korn0055/bean-bag-toss/spice_models/readme.txt

Adam Bush

The only difference between the MAX9031 and the MAX9021 actually used in circuit is prop delay and current draw.  Supply voltages, and input ranges are the same.  It should be ok for simulation purposes.
