korn0055/bean-bag-toss/drawings/laser_cutout.pdf

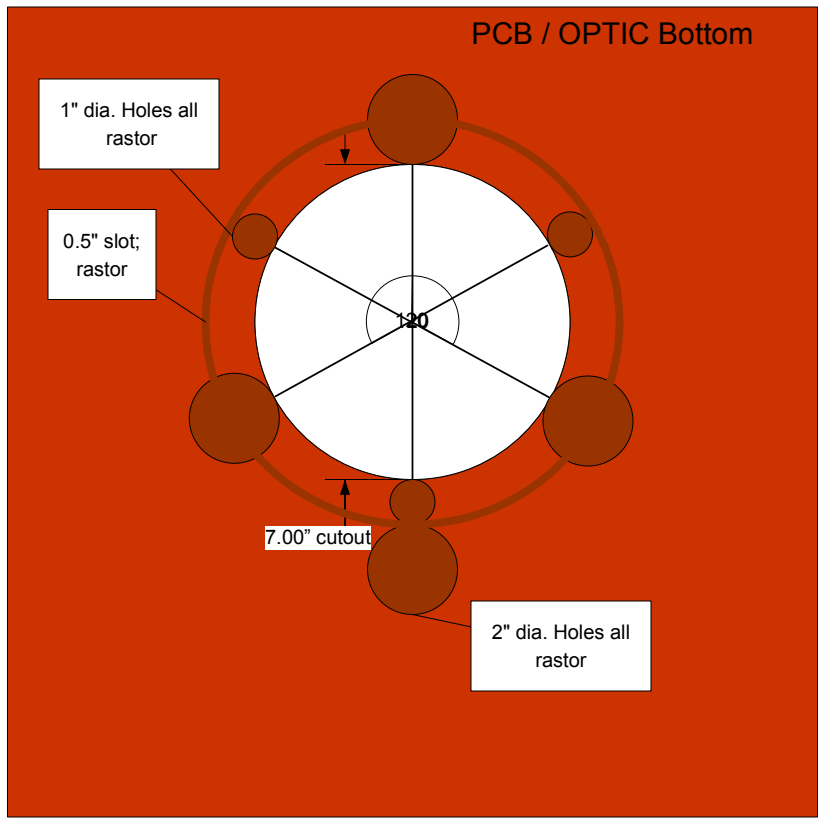
[picture p1: figure]
7.00” cutout; PCB / OPTIC Bottom; 1" dia. Holes all; rastor; 0.5" slot;; 2" dia. Holes all
