korn0055/bean-bag-toss/drawings/frame/frame.png

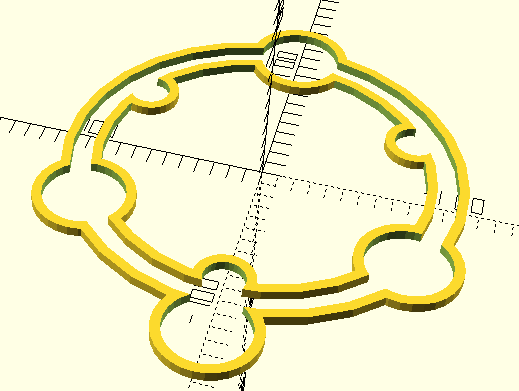
drawings/frame/frame.png
