korn0055/bean-bag-toss/pcb/BOM_grouped.xlsx

# | RefDes | Value | Name | Quantity | Total/Panel | Stock | Note | Digikey Number | Qty | Unit cost | Cost | Mouser | Qty | Unit cost | Cost | Dirty PCB | Order Number
1 | C1 | 3.3pF | CAP_0402 | 1 | 1 | Y | Sub 3.5pF | 1276-1692-1-ND | 100 | 0.0051 | $0.51 |  |  |  |  | PCBs | File | Layers | Size (actual) | Color | Thickness | Coating | Stencil | Processing | Quantity | Charge | Status
2 | C2 | 4.7uF | CAP_0603 | 1 | 1 | N |  | 587-1441-1-ND | 10 | 0.157 | $1.57 |  |  |  |  | 5207 | Optical_txrx.zip | 2 | 10x10cm (10x10cm) | Blue | 1.6mm | ENIG | Steel | Rush | Protopack ±10 | $90 | Shipped
3 | C3 | 15uF | CAP_0805 | 1 | 1 | N | sub 10uF | 1276-2891-1-ND | 10 | 0.205 | $2.05 |  |  |  |  | Total
4 | C4 | 47nF | CAP_0402 | 1 | 1 | N |  | 1276-1750-1-ND | 10 | 0.011 | $0.11 |  |  |  |  | Shipping | DHL China (3-9 days) |  |  |  |  |  |  |  |  | $15 | 0.42kg
5 | C5, C6 | 1uF | CAP_0402 | 2 | 2 | Y |  | 709-1222-1-ND | 25 | 0.0996 | $2.49 |  |  |  |  | Total |  |  |  |  |  |  |  |  |  | $105
6 | C7 | 1n | CAP_0402 | 1 | 1 | Y |  | 709-1133-1-ND | 25 | 0.022 | $0.55
7 | C8 | PH_RES | CAP | 1 | 1 | N |  | PDV-P8103-ND | 2 | 0.89 | $1.78
8 | C101, C103 | 0.1uF | CAP_0402 | 2 | 6 | Y |  | 709-1129-1-ND | 25 | 0.0452 | $1.13 |  |  |  |  | PROJECT TOTAL TO DATE:
9 | C102 | 10nF | CAP_0402 | 1 | 3 | Y |  | 709-1127-1-ND | 50 | 0.0208 | $1.04 |  |  |  |  |  | Digikey = | $79.30
10 | C104 | 500pF | CAP_0402 | 1 | 3 | Y | sub 1n or 220pF |  |  |  |  |  |  |  |  |  | Mouser = | $12.13
11 | D1 |  | DIODE_0603 | 1 | 1 | N | Actually SOD-123 | SD101AWTPMSCT-ND | 10 | 0.322 | $3.22 |  |  |  |  |  | DirtyPCB = | $105
12 | D101, D102 |  | DIODE_0402 | 2 | 6 | N | shouldn't need | 641-1287-1-ND | 6 | 0.52 | $3.12
13 | D103 |  | PD | 1 | 3 | Y
14 | J1, J4 |  | 644456-2 | 2 | 2 | DNP |  |  |  |  |  |  |  |  |  |  | TOTAL = | $196.43
15 | J2 |  | 87758-06 | 1 | 1 | N |  | 952-2121-ND | 10 | 0.214 | $2.14
16 | J3, J5, J6, J101, J102 |  | 951106-4620 | 5 | 9 | DNP
17 | L1 | 4.7uH | SRN5020-4R7M | 1 | 1 | N |  | SRN5020-4R7MCT-ND | 10 | 0.32 | $3.20
18 | Q1, Q2, Q3 |  | BS870 | 3 | 3 | N |  | BS870-FDICT-ND | 6 | 0.35 | $2.10
19 | Q5 |  | AO3416 | 1 | 1 | N |  | 785-1011-1-ND | 2 | 0.4 | $0.80
20 | Q101, Q102 |  | 2SK1828 | 2 | 6 | N |  | 2SK1828TE85LFCT-ND | 12 | 0.324 | $3.89
21 | R1 | 1MEG | RES_0402 | 1 | 1 | Y | Can't sub value | RHM1.00MCDCT-ND | 100 | 0.0052 | $0.52
22 | R2 | 115k | RES_0402 | 1 | 1 | N | Can't sub value | P115KLCT-ND | 100 | 0.0149 | $1.49
23 | R3, R4, R5 | 200 | RES_0402 | 3 | 3 | Y |  | 311-200LRCT-ND | 100 | 0.006 | $0.60
24 | R6 | 10k | RES_0402 | 1 | 1 | Y |  | RHM10.0KCDCT-ND | 100 | 0.0052 | $0.52
25 | R7, R104 | 100k | RES_0402 | 2 | 4 | Y |  | RHM100KCDCT-ND | 100 | 0.0052 | $0.52
26 | R101, RX1, RX2, RX3 | 50 | RES_0402 | 4 | 4 | Y | sub 51 ohm | RHM51.0CDCT-ND | 100 | 0.0052 | $0.52
27 | R102 | 2MEG | RES_0402 | 1 | 3 | Y |  | RHM2MCDCT-ND | 100 | 0.0074 | $0.74
28 | R103, R106, R108 | 332k | RES_0402 | 3 | 9 | Y | sub 330 | 311-330KLRCT-ND | 100 | 0.006 | $0.60
29 | R109 | 1X | RES_0402 | 1 | 3 | Y |  | ***See above
30 | U1 |  | LT3467ES6 | 1 | 1 | N |  | LT3467ES6#TRMPBFCT-ND | 3 | 4.16 | $12.48
31 | U2 |  | MCP1801_OT | 1 | 1 | N |  | MCP1801T-5002I/OTCT-ND | 4 | 0.5 | $2.00
32 | U3 |  | ATTINY24_QFN | 1 | 1 | N |  | ATTINY24-20MU-ND | 2 | 2.93 | $5.86
33 | U101 |  | MAX9021AUK-T | 1 | 3 | N |  | ***Non stock |  |  |  | 700-MAX9021AUKT | 6 | 0.69 | 4.14
34 | U102 |  | AD8061ARTZ | 1 | 3 | N |  | AD8061ARTZ-REEL7CT-ND | 6 | 2.27 | $13.62
 |  |  |  | 53 |  |  |  |  |  | Subtotal | $69.17 |  |  | Subtotal | $4.14
 |  |  |  |  |  |  |  |  |  | Shipping (est) | 5.1 |  |  | Shipping (est) | 7.99
 |  |  |  |  |  |  |  |  |  | Tax | 5.03 |  |  | Total = | $12.13
 |  |  |  |  |  |  |  |  |  | Total = | $79.30
