korn0055/bean-bag-toss/drawings/frame/frame.stl

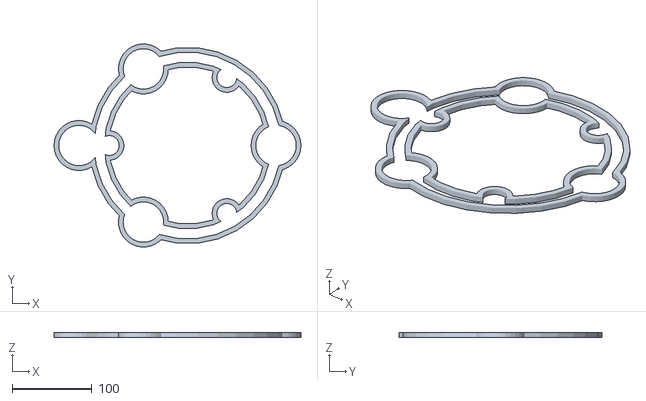
[picture p3: CAD file, 2015-06-09]
drawings/frame/frame.stl
310.5 x 254.9 x 6.00
