korn0055/bean-bag-toss/(list of files, cad)

Other CAD files:
drawings/frame/frame.dxf
