korn0055/bean-bag-toss/(list of files, drawings)

Other design files:
pcb/beanbagtoss.dch
pcb/beanbagtoss.dip
