korn0055/bean-bag-toss/drawings/FaceDown-3x2-board-instructions.pdf

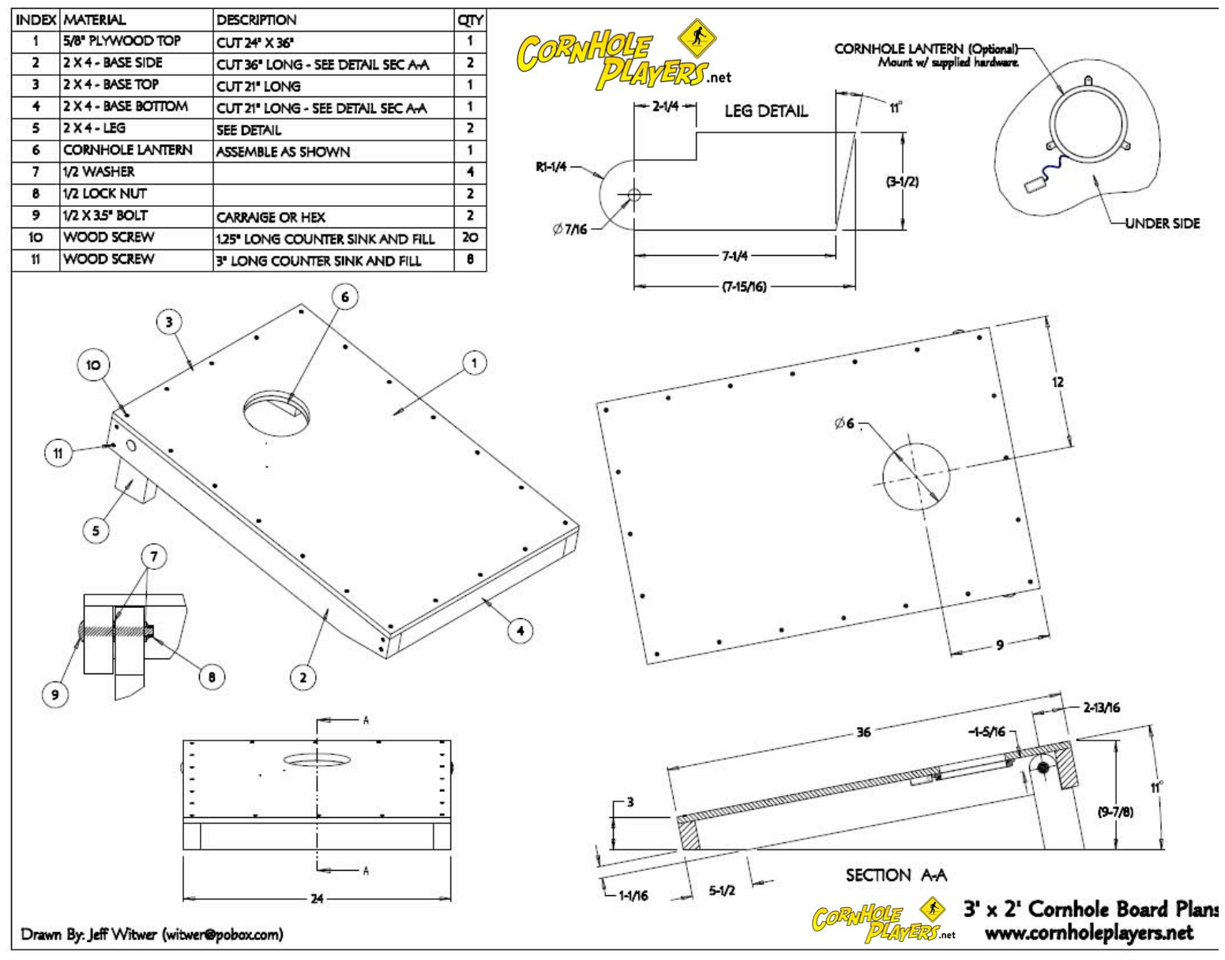
[picture p4: page 1]
