korn0055/bean-bag-toss/pcb/assembly_aid.jpg

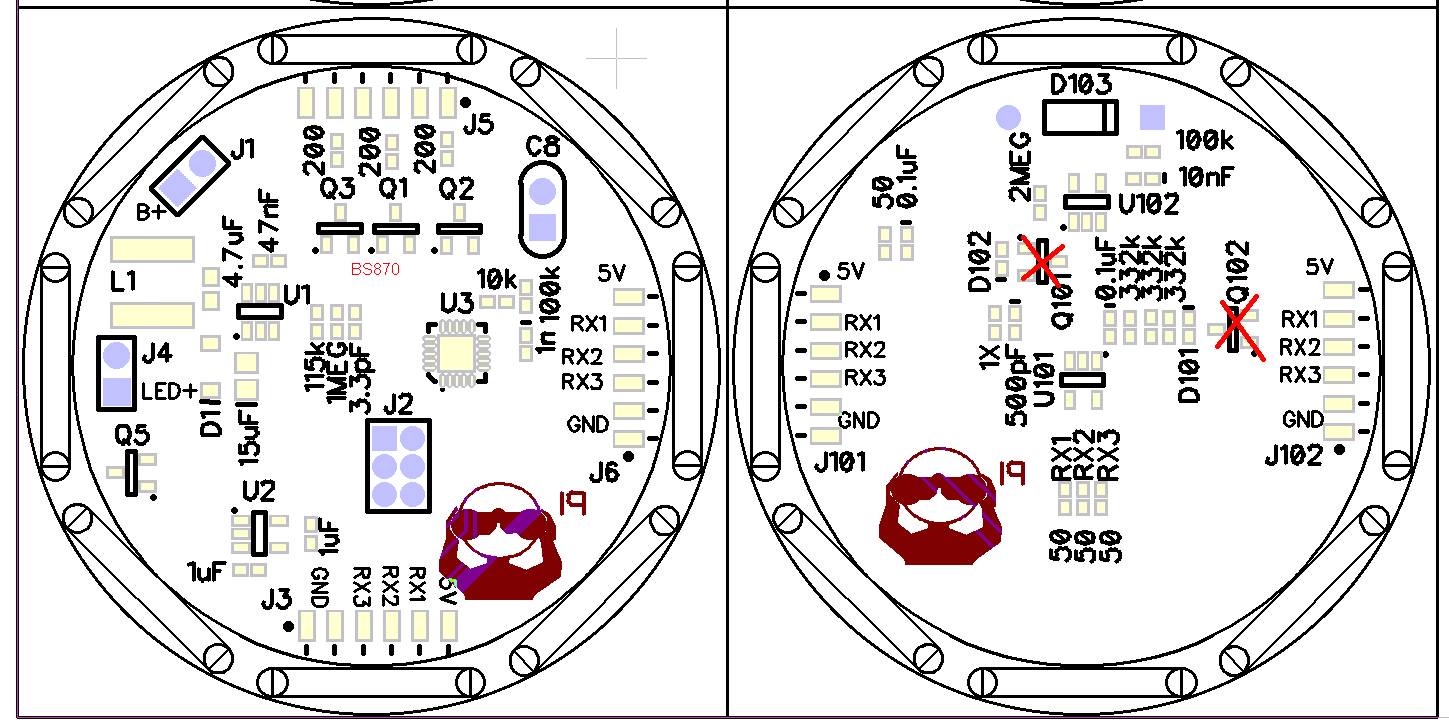
pcb/assembly_aid.jpg
