korn0055/bean-bag-toss/(threads)

Thread 1 (2015-01-23):

Change 12V LED drive transistor

korn0055, 2015-01-23:
Change 12V LED drive transistor from FMMT918 to AO3416.  Pinout is same.  Change is need to support higher current and we need to use FET, since there is no current limiting resistor on the base (gate)

NothingButGunpowder, 2015-03-03:
Part changed to an AO3416, low Rds on device.

Closed 2015-03-05.

Thread 2 (2015-01-23):

increase trace size from 12V LED connector to transistor

korn0055, 2015-01-23:

NothingButGunpowder, 2015-03-03:
Trace size increased to 0.8mm.  Not much more room near board edge for anything larger.

NothingButGunpowder, 2015-03-05:
Traces are >0.8mm - PCB guides for 1oz copper suggest about 0.3mm or larger.

Closed 2015-03-05.

Thread 3 (2015-01-23):

Add ambient light sensing circuit

korn0055, 2015-01-23:
Add another photodiode with a big cap on the main board, route to ADC (pin 2?)

NothingButGunpowder, 2015-03-03:
Recommend saving for rev 2 as a different technique is needed vs. the pulse sensing circuits on there right now.

NothingButGunpowder, 2015-03-05:
Added simple voltage divider cell.

Closed 2015-03-05.

Thread 4 (2015-01-23):

change through hole connectors to surface mount (except programming header)

korn0055, 2015-01-23:
Surface mount pads will be easier to solder to and won't require a 90 hard degree turn when mounting.

NothingButGunpowder, 2015-03-03:
Connectors for receiver circuits and emitter outputs moved to surface mount.  Connectors for battery and LED flashing left as through hole for current support, but doesn't preclude using surface mount soldering.

Closed 2015-03-05.

Thread 5 (2015-01-23):

Move receiver power to uC pin (one of the freed pins from (8))

korn0055, 2015-01-23:
This way the analog receive circuitry is power directly from the micro so that it can be turned off to conserve power.

NothingButGunpowder, 2015-03-03:
Moved to uC pin 14, PB2.

Closed 2015-03-03.

Thread 7 (2015-01-23):

Make gerber and check outer routing (too big/small for angle cutters?)

korn0055, 2015-01-23:
Check to see if the routing is too too big/small for angle cutters?

NothingButGunpowder, 2015-03-03:
Spacing in board routing is about 0.1", but the slots are only 2 mm wide.  Those might be a bit tight for angle cutters, but the bandsaw should handle it no problem.

Closed 2015-03-05.

Thread 8 (2015-01-23):

Replace emitter drive bjt with correct mos transistor

korn0055, 2015-01-23:
Tie all gates to same pin on uC (free up pin for receive circuitry power control)

NothingButGunpowder, 2015-03-03:
BJT transistor updated to MOSFET, BS870.

NothingButGunpowder, 2015-03-05:
i=C*dv/dt, 50pF max gate cap and 20mA drive means <40ns turn on for 3 devices in parallel.

Closed 2015-03-05.

Thread 9 (2015-01-26):

decide on a main power switch

korn0055, 2015-01-26:

NothingButGunpowder, 2015-03-03:
Now that the power switch was moved to the battery location we don't need to decide on this before sending the board out.

Thread 10 (2015-03-18):

fix programming header spacing

korn0055, 2015-03-18:
The current 6-pin programming header hole spacing is metric, but should be 0.1" to match the mating connector.

Thread 11 (2015-03-18):

reverse battery protection

korn0055, 2015-03-18:
Would it be worth inserting a position for a reverse battery protection diode?

Thread 13 (2015-03-18):

ambient light sensor

korn0055, 2015-03-18:
Implement A/D routines to read ambient level from photo resistor and adjust "off" brightness level

korn0055, 2015-03-19:
There is a lot of noise (>100mV p-p) on the photo resistor with just one emitter and the small LED strip running.  From testing indoors with a 100k series resistor, it looks like the threshold will need to be a couple hundred millivolts, so some filtering will be needed.  The plan is to use a first-order IIR filter: y[0] = (1-alpha)*x[0] + y[-1] with alpha close to unity in order to filter the noise.  A warm-up time will be required before the filter output can be used to make any decisions.

NothingButGunpowder, 2015-03-19:
You could also try stacking a cap on top of the existing resistor to filter the noise.  Is the noise synchronous with the other devices pulsing or could it be noise from overhead lights being picked up at 60 Hz?

Thread 14 (2015-03-18):

battery voltage measurement

korn0055, 2015-03-18:
Add a voltage divider across the battery and run it into an A/D channel to determine when the battery is getting low.  If the battery is low, then a special pattern can be flashed to notify the user before the system acts erratically due to power brown outs.
