korn0055/bean-bag-toss/(commit log)

2015-01-23 added diptrace pcb files
    [beanbagtoss.dch, beanbagtoss.dip]
2015-02-03 Added pull up on NRESET. Testing the commit procedure.
    [beanbagtoss.dch, beanbagtoss.dip]
2015-02-04 Added 12V LED driving NMOS datasheet to project.
2015-02-04 In process of updating schematic and layout in support of open issues 1, 2, 4, 5, 6, 7 and 8.
    [beanbagtoss.dch, beanbagtoss.dip]
2015-02-04 Adding BS870 NMOS datasheet for emitter mosfet.
2015-02-06 PCB issue updates in progress
    [5V.gbr, Bottom.gbl, BottomMask.gbs, BottomSilk.gbo, GND.gbr, Top.gtl, TopMask.gts, TopSilk.gto]
2015-02-06 copper fills updated drc in progress removed lock file
    [beanbagtoss.dip]
2015-02-19 PCB updates to date.
2015-02-20 Nearly completed receiver board. Need to debug metal fill issue.
2015-02-24 Updated to 2 layer board with new design rules. Should be very close to final layout. Need to add artwork, and array the receiver board. Double check all log issues are addressed in the repository.
    [beanbagtoss.dch, beanbagtoss.dip]
2015-02-25 Changed over silkscreen to show value instead of reference designator. Added ProtoInsight logo to back.
    [beanbagtoss.dch, beanbagtoss.dip]
2015-02-26 Adding an assembly drawing of the project.
2015-02-28 Found 1A diode/ inductor footprints. Learned switcher won't support full LED strip, but if we limit to shorter piece in around the hole it'll be ok.
    [beanbagtoss.dch, beanbagtoss.dip]
2015-03-03 Could be final PCB? Need to check against tasks in repository.
    [5V.gbr, BoardOutline.gbr, Bottom.gbl, BottomMask.gbs, BottomSilk.gbo, GND.gbr, Top.gtl, TopMask.gts]
2015-03-03 Removing old board files from autotrax. We won't be using autotrax.
2015-03-05 Boards updated and submitted!!!
    [Bottom.gbl, BottomMask.gbs, BottomPaste.gbr, BottomSilk.gbo, Top.gtl, TopMask.gts, TopPaste.gbr, TopSilk.gto]
2015-03-18 added emitter drive PWM code
2015-03-20 cleaned up hardcoding; added "sleep signal"; worked on ambient light sensing (not working)
    [FirstOrderIIRFilter.xlsx]
2015-03-20 added tau calculation to IIR filter doc
    [FirstOrderIIRFilter.xlsx]
2015-03-24 New amplifier with low input bias current and lower supply current.
2015-03-27 Ambient light sensor is now working with filter; added "breathing" night mode
2015-04-08 Adding 3d printing files to project
    [frame.scad]
2015-05-18 disabled obstacle checking while flashing so that a blocked beam won't flash continuously
    [BeanBagController.c]
2015-06-09 LED information
    [frame.scad]
2015-06-11 modified detection code so that a flash is only triggered after an object has cleared the beam it blocked; the current implementation is too susceptible to noise to use it night mode, so it is disabl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
    [BeanBagController.c]
2015-06-30 cleaned up compiler warnings; adjusted PWM levels and periods
